nonasking/daijin/docs/README.md

# docs

지금 시스템을 설명하는 문서와, 그때의 판단을 남긴 문서를 나눈다. 코드가 바뀌면 **현행** 문서만 같이 고친다.

## 현행

| 문서 | 무엇 |
|---|---|
| [chunking-protocol.md](chunking-protocol.md) | 오디오 청킹 프로토콜: 헤더 `[clipId][seq:2][flags]`, 양방향 ADPCM, 재조립 규칙 |
| [design-self-layer.md](design-self-layer.md) | 자아 층 설계: 장부·추동·기억·반성, 로컬 음성 스택, "일부러 꺼 둠" |
| [broker-credentials.md](broker-credentials.md) | 브로커 자격증명을 브레인·디바이스·노드로 나누는 이유와 방법 |
| [research-self-local.md](research-self-local.md) | 자아의 방향과 외부 API 없는 구성 리서치 (비공개) |

## 기록 (그때의 계획, 지금과 다를 수 있다)

| 문서 | 무엇 | 지금과 다른 점 |
|---|---|---|
| [demo-video-plan.md](demo-video-plan.md) | 2026-09 데모 영상 기획. 영상은 찍었다 (README의 Demo) | dev2 는 서보가 아니라 스텝모터 간식 디스펜서가 됐다 (`voice/nodes.json`) |
| [learning-roadmap.md](learning-roadmap.md) | 2026-06 키트 배송 전 학습 로드맵 | 학습 단계는 끝났다 |
| [daily-plan.md](daily-plan.md) | 2026-06 교재 기준 일별 계획 | 같음 |
| [day1-checklist.md](day1-checklist.md) | 2026-06 도착 첫날 체크리스트 | 같음 |
| [study-resources.md](study-resources.md) | 2026-06 입문·트러블슈팅 자료 큐레이션 | 자료 자체는 아직 쓸 만하다 |
| [research-cloud-robotics.md](research-cloud-robotics.md) | 2026-06 Cloud Robotics 리서치 (deep-research) | 클라우드 브로커 선택의 근거로 남는다 |

개선 과제의 우선순위 표는 [`research/2026-10-improvements/report.md`](../research/2026-10-improvements/report.md) (비공개).
