nonasking/daijin/docs/research-cloud-robotics.md

# 리서치: 내 IoT 원격제어 프로젝트 ↔ Cloud Robotics & Teleoperation

> deep-research 결과 (2026-06-14). 23개 소스 → 111개 주장 추출 → 25개 적대적 검증 → **21개 확정, 4개 기각**.
> 목적: 내 프로젝트가 Physical AI(cloud robotics·teleoperation)와 닿는지 검증 + 아이디어 발굴.

## 🧭 이 보고서를 어떻게 쓸 것인가 (작업 철학 — 먼저 읽기)
이 보고서는 **검증기·가속기**로 쓰는 것이지 **아이디어 생성기**로 쓰는 게 아니다. 두 층으로 분리해서 사용:
- **구현층 (어떻게 만드나)** → 여기 담긴 prior art(MQTT/WebRTC 이중 프로토콜, micro-ROS 등)를 **탐욕적으로 흡수.** 삽질(불필요한 트러블슈팅)을 줄이는 순이익.
- **비전·발상층 (무엇을·왜 만드나)** → 이 보고서를 **느슨하게** 쥔다. "원래 이렇겐 안 한다"가 아이디어를 죽이게 두지 않는다.
- 한 줄: **"구현은 탐욕적으로, 비전은 순진하게."**
- 순서: **발산(자유 발상) 먼저 → 그 다음 이 보고서로 매핑/검증.** 프레임워크와 **갈라지는 지점은 오류가 아니라 차별화 후보(기회 신호).**
- 🔖 **"원래는 안 하는 건데" 노트**: 분야 자료에서 "보통 이렇겐 안 하더라" 싶은 게 나오면 지우지 말고 적어둔다 → 대부분의 차별화가 여기서 나온다.

> 프레임워크 = 존재하는 것의 *지도*(descriptive)이지 가능한 것의 *규칙*(prescriptive)이 아니다. 가두는 건 프레임워크가 아니라 그걸 규칙으로 착각하는 나 자신.

---

## 한 줄 결론
가설은 **강하게 지지됨** — 단 정확한 위치는 "cloud robotics 그 자체"가 아니라 **"teleoperation의 입문 골격 + cloud robotics에 인접한 인프라"**. 이 교차점은 실제로 활발한 연구·창업 영역.

⭐ **그리고 이 "갈라지는 지점"이 핵심**: 아래 §1에서 내 프로젝트가 정의에서 벗어나는 부분(자가호스팅·0원·프라이버시 우선)은 **약점이 아니라 나만의 각도 = 차별화 무기**다. 분야를 알았기에 이 윤곽이 선명해진 것 — 프레임워크가 아이디어를 가둔 게 아니라 *드러낸* 사례.

---

## 1. 가설 검증 (정직하게)

### ✅ 진짜 닿아 있음 — 비유가 아니라 같은 부품
2025년 학술 논문(arXiv:2510.11421)이 **정확히 내 스택**으로 6-DOF 로봇팔을 원격조작:
> *"affordable microcontrollers (ESP8266...), and protocols like MQTT and WebRTC... low-cost, scalable robotic teleoperation"* — 제어=MQTT, 영상=WebRTC, 액추에이터=ESP 보드.

ESP32-S3는 ESP8266의 상위 호환 → 취미 프로젝트와 학술 teleoperation이 **동일 프리미티브 연속선상**. (검증 3-0)

### ⚠️ 정직하게 갈라지는 지점
- **Cloud robotics 정의적 핵심 = 연산 오프로딩 + (부분)자율성 + 로봇** (Kuffner 2010 "shared brain"). 내 프로젝트엔 아직 로봇·자율성·오프로딩 없음 → "cloud robotics 그 자체" 아님, **인접 인프라**. (3-0)
- 지금은 **telepresence**(원격에 있다는 감각)이지 **co-presence**(곁에 있다는 지각)는 아직. (3-0)

### 📍 정확한 좌표
teleoperation 스펙트럼의 *"원격 명령"* 끝, 자율성 0. **액추에이터(서보/모터 — 키트에 있음) + 자율성 + 피드백 루프**를 더하면 본격 진입.

---

## 2. 아이디어 발굴 (단계별)

### 🟢 당장 (지금 키트로)
- **이중 프로토콜 분리** ⭐: 제어=MQTT(저지연), 영상=WebRTC — 한 채널에 다 넣지 말 것. 학술 프레임워크가 의도적 설계로 사용("avoiding bottlenecks typical of monolithic architectures"). ESP32-S3 내장 카메라 영상은 WebRTC로, 제어는 MQTT로. (3-0)
- **센서→broker→원격접근 텔레메트리**: 부모님댁 PIR/온습도 = 학술 "sensor-to-cloud health telemetry"와 동일 패턴. (3-0)

### 🟡 중간 (개념 승격 — "취미→로보틱스" 다리)
- **micro-ROS로 ESP32를 표준 ROS2 노드로 편입** ⭐: 지금 `curl` LED 제어를 ROS2 `/cmd_vel` 토픽으로 승격 → 정식 로보틱스 스택 참여. 체인: `gamepad→teleop→/cmd_vel→micro-ROS Agent→UDP/WiFi→ESP32→PWM`. (참고: Reinbert/ros_esp32cam_diffdrive) (3-0)
- **teleoperation 향상 3축**: ① 운영자 지각(시점/자동화) ② 인터페이스(VR/AR) ③ 제어(latency 보상, 로컬 자율성). (3-0)
- **액추에이터 추가**(서보·모터·릴레이): "표시(LED)"→"물리 작동" = cloud robotics 정의에 근접.

### 🔴 야심 (방향성)
- 모바일 로봇 + 가족이 폰으로 원격조작 + 영상통화 (TurtleBot/ROS 사례) (3-0)
- 자율주행(topological map) telepresence 로봇 — teleoperation 없이 자율 순찰 (3-0)
- **telepresence → co-presence** 진화 (모니터링 → 진정한 원격 현존)
- **자가호스팅 WebRTC 영상 스택**: 방화벽 뒤 ~130ms·E2E 암호화, "Local Mode"(오프라인 자가호스팅) — 내 0원·자가호스팅 철학과 정확히 일치. (3-0)

---

## 3. 핵심 용어
| 용어 | 의미 |
|---|---|
| **Cloud robotics** | cloud + service robotics, 로봇 연산 오프로딩(massively parallel) |
| **Edge computing** | 처리를 엣지로 → latency↓ (edge ~1-10ms vs cloud ~50-200ms) |
| **Teleoperation** | 완전자율 아직 불가 → 인간 원격제어가 실용적 중간지대 |
| **telepresence vs co-presence** | 원격에 있다는 감각 vs 곁에 있다는 지각 |
| **micro-ROS / DDS** | MCU를 ROS2 그래프에 편입(Agent 브리지 경유) |

---

## 4. 진지한 방향 (연구·창업)
- **노인 돌봄 × telepresence = 활성 연구·파일럿·창업 영역** (저비용 AAL, telepresence 로봇 실배치). 기회가 실재. (3-0 / 일부 2-1)
- **내 차별점 = 무기**: 대부분 시스템이 제3자 클라우드 의존인데, 나는 **자가호스팅·0원·프라이버시 우선**. 프라이버시 중시 노인 모니터링은 시장·연구의 **틈새**.

---

## ⚠️ 신뢰도 주의 (검증서 기각/약화)
- **latency 구체 수치 불신**: "MQTT 128.4ms vs WebSocket" 등은 preprint 단일팀·통계검증 없음(2-1, 일부 1-2/0-3 기각). 방향성만 참고, **수치는 직접 측정**.
- "국제망 실시간 teleoperation" 주장은 **반박됨**.

## 📚 핵심 소스
- ⭐ Sun & Tsai, *A Modular AIoT Framework for Low-Latency Real-Time Robotic Teleoperation* — arXiv:2510.11421 (2025) — ESP+MQTT+WebRTC (내 스택과 거의 동일)
- Tahir & Parasuraman, *Edge Computing and its Application in Robotics: A Survey* — arXiv:2507.00523 / MDPI JSAN 2025
- Saha & Dasgupta, *A Comprehensive Survey of Recent Trends in Cloud Robotics* — MDPI Robotics 2018, 7(3):47
- Moniruzzaman et al., *Teleoperation methods and enhancement techniques for mobile robots* (2022)
- Reinbert/ros_esp32cam_diffdrive (GitHub) — micro-ROS ESP32 `/cmd_vel`

---

## 추천 다음 한 걸음
지금 HTTP/curl 제어를 **MQTT로 옮기고 + ESP32-S3 카메라를 WebRTC(또는 우선 MJPEG)로** 붙이면 그 자체로 "teleoperation 이중 프로토콜" 아키텍처 완성. 이후 **micro-ROS 승격**이 로보틱스 본격 진입 다리.
