nonasking/daijin/sketches/15-home-node/broker_choice.h

// 우체국 고르기: 평소엔 클라우드(daijin.inanna.day, TLS), 클라우드에 못 붙으면 집의 우체국(mosquitto, 같은 와이파이)으로.
// 인터넷이 통째로 끊겨도 기기·노드·맥의 브레인이 집 안에서 계속 말을 주고받게 하려는 것.
//
// secrets.h 에 MQTT_LOCAL_HOST 를 넣었을 때만 켜진다 (넣지 않으면 지금까지와 똑같이 클라우드만 쓴다):
//   #define MQTT_LOCAL_HOST "my-mac.local"   // 집 mosquitto 가 도는 기계: 이름(.local, mDNS) 또는 고정 IP
//                                            // 이름을 권한다: 공유기가 IP 를 바꿔도 따라간다 (2026-10-12 실제로 .143 → .189)
//   #define MQTT_LOCAL_PORT 1883
// 계정은 클라우드와 같은 것(MQTT_USER/MQTT_PASS)을 쓴다: 집 우체국도 같은 계정·같은 ACL 이다 (voice/mosquitto/home.acl).
// 예전엔 보드 전부가 공용 계정 하나(MQTT_LOCAL_USER "iot")로 붙었고, 그 비밀번호 하나면 집 우체국에서 무엇이든 할 수 있었다.
// 집 우체국의 계정이 정말 달라야 하면 MQTT_LOCAL_USER / MQTT_LOCAL_PASS 를 따로 적는다.
// 동작: 시각을 못 얻어 인증서를 검증할 수 없거나 클라우드 접속이 3번 연달아 실패하면 집 우체국으로 간다.
//       집 우체국에 있는 동안 5분마다 클라우드를 다시 시도하고, 붙으면 돌아간다. 집 우체국에 붙어 있는 중이면 dueForCloud() 가
//       5분이 됐음을 알려 주고, 호출자가 한가할 때 연결을 끊어 다시 고르게 한다 (2026-11-01 리뷰: choose() 는 끊겨 있을 때만 불려서
//       집 우체국에 한번 붙으면 브로커가 돌아와도 거기 머물렀다).
// 집 우체국은 같은 와이파이 안이라 암호화 없이(평문) 붙는다. 그 망을 믿을 수 있을 때만 쓸 것.
//
// 14-daijin 과 15-home-node 에 같은 파일이 들어 있다 (tls_time.h 처럼 스케치마다 한 벌).
#pragma once
#include <WiFi.h>
#include <WiFiClientSecure.h>
#include <PubSubClient.h>
#include "tls_time.h"
#if defined(MQTT_LOCAL_HOST)
#include <ESPmDNS.h>
#endif

#if defined(MQTT_LOCAL_HOST)
#define HAS_LOCAL_BROKER 1
#ifndef MQTT_LOCAL_PORT
#define MQTT_LOCAL_PORT 1883
#endif
#else
#define HAS_LOCAL_BROKER 0
#endif

struct BrokerChoice {
  WiFiClientSecure* tls = nullptr;
  WiFiClient plain;
  PubSubClient* mqtt = nullptr;
  bool onLocal = false;
  bool tlsReady = false;            // 클라우드용 인증서 검증 준비가 끝났나 (시각을 얻었나)
  uint8_t cloudFails = 0;
  uint32_t localSince = 0;
  bool resolveAgain = false;        // 집 우체국 접속이 실패했으면 다음 시도 전에 이름을 다시 찾는다
  static const uint8_t CLOUD_FAILS_TO_LOCAL = 3;
  static const uint32_t RETRY_CLOUD_MS = 5UL * 60 * 1000;

  void begin(WiFiClientSecure& t, PubSubClient& m, bool clockReady) {
    tls = &t; mqtt = &m; tlsReady = clockReady;
    if (tlsReady) tls->setCACert(ISRG_ROOT_X1);
    useCloud();
  }
  bool enabled() const { return HAS_LOCAL_BROKER; }
  const char* name() const { return onLocal ? "local" : "cloud"; }
  const char* user() const {
#if HAS_LOCAL_BROKER && defined(MQTT_LOCAL_USER)
    if (onLocal) return MQTT_LOCAL_USER;
#endif
    return MQTT_USER;
  }
  const char* pass() const {
#if HAS_LOCAL_BROKER && defined(MQTT_LOCAL_PASS)
    if (onLocal) return MQTT_LOCAL_PASS;
#endif
    return MQTT_PASS;
  }
  void useCloud() {
    onLocal = false;
    mqtt->setClient(*tls);
    mqtt->setServer(MQTT_HOST, MQTT_PORT);
  }
  void useLocal() {
#if HAS_LOCAL_BROKER
    onLocal = true; localSince = millis(); resolveAgain = false;
    mqtt->setClient(plain);
    IPAddress ip;
    if (resolveLocal(ip)) mqtt->setServer(ip, MQTT_LOCAL_PORT);
    else mqtt->setServer(MQTT_LOCAL_HOST, MQTT_LOCAL_PORT);   // IP 로 적었거나 못 찾았으면 그대로 (못 찾으면 접속이 실패하고 다시 찾는다)
#endif
  }
#if HAS_LOCAL_BROKER
  // "이름.local" 이면 mDNS 로 지금의 IP 를 찾는다.
  static bool resolveLocal(IPAddress& out) {
    String host = MQTT_LOCAL_HOST;
    if (!host.endsWith(".local")) return false;
    static bool mdnsUp = false;
    if (!mdnsUp) {
      char me[24]; snprintf(me, sizeof me, "daijin-%06llx", ESP.getEfuseMac() & 0xFFFFFF);
      mdnsUp = MDNS.begin(me);
    }
    if (!mdnsUp) return false;
    out = MDNS.queryHost(host.substring(0, host.length() - 6), 2000);
    Serial.printf("집 우체국 %s → %s\n", MQTT_LOCAL_HOST, out == IPAddress() ? "못 찾음" : out.toString().c_str());
    return out != IPAddress();
  }
#endif
  // 집 우체국에 붙어 있고 클라우드를 다시 볼 때가 됐나. 호출자는 재생·녹음 중이 아닐 때 mqtt->disconnect() 하고 다시 접속한다.
  bool dueForCloud() const { return HAS_LOCAL_BROKER && onLocal && mqtt && mqtt->connected() && millis() - localSince >= RETRY_CLOUD_MS; }
  // 접속 시도 직전에 부른다: 어느 우체국으로 갈지 정한다. 바뀌었으면 true.
  bool choose() {
    if (!HAS_LOCAL_BROKER) return false;
    if (onLocal) {
      if (millis() - localSince < RETRY_CLOUD_MS) {
        if (resolveAgain) { uint32_t since = localSince; useLocal(); localSince = since; }
        return false;
      }
      if (!tlsReady && syncClock(3000)) { tls->setCACert(ISRG_ROOT_X1); tlsReady = true; }
      localSince = millis();                       // 실패해도 다음 재시도는 5분 뒤
      if (!tlsReady) return false;
      cloudFails = CLOUD_FAILS_TO_LOCAL - 1;      // 한 번 더 실패하면 바로 집으로 돌아온다
      useCloud(); return true;
    }
    if (!tlsReady || cloudFails >= CLOUD_FAILS_TO_LOCAL) { useLocal(); return true; }
    return false;
  }
  // 접속 시도 결과를 알려 준다.
  // 시험용: -DBROKER_TEST_CLOUD_DOWN 으로 빌드하면 클라우드 접속이 늘 실패한 것으로 친다 (인터넷을 끊지 않고 폴백을 보려고).
  // 돌려주는 값이 실제로 붙었는지다 (시험 빌드에서는 클라우드 접속을 끊고 false).
  bool result(bool ok) {
#ifdef BROKER_TEST_CLOUD_DOWN
    if (!onLocal) { cloudFails = 255; if (ok) mqtt->disconnect(); return false; }
#endif
    if (onLocal) { resolveAgain = !ok; return ok; }
    cloudFails = ok ? 0 : (cloudFails < 255 ? cloudFails + 1 : 255);
    return ok;
  }
};
