nonasking/daijin/sketches/12-mqtt-led-funnel/ca_cert.h

// Funnel(Let's Encrypt) 서버 검증용 루트 CA — 공개 인증서(비밀 아님)
#pragma once
const char* ISRG_ROOT_X1 = R"EOF(
-----BEGIN CERTIFICATE-----
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
-----END CERTIFICATE-----
)EOF";
