nonasking/daijin/(commit log)

2026-06-20 daijin — ESP32-S3 AI voice friend IoT (public snapshot)
2026-07-04 daijin Phase 2: the device listens and speaks — full streaming voice pipeline
    Device (sketches/14-daijin): INMP441 record (32-bit I2S, tap-toggle) ->
    chunked upload over HiveMQ TLS -> jitter-ring-buffer playback through
    PCM5102 amp module. WiFiMulti (home + phone hotspot), modem sleep off,
    ready chirp + idle LED. Verification tools: test-mic, test-speaker,
    mic-diag (empirical I2S pin sweep).
    Brain (voice/daijin_mqtt.py): sentence-streaming replies (claude
    stream-json -> TTS per sentence -> publish immediately), ElevenLabs
    custom voice with macOS fallback and TTS_ENGINE switch, IMA ADPCM 4:1
    encode (EU-broker RTT x ESP32 TCP window caps ~19KB/s; PCM needs 32,
    ADPCM needs 8), QoS0 streaming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
    [14-daijin.ino, ca_cert.h, mic-diag.ino, test-mic.ino, test-speaker.ino]
2026-07-04 Unlock full agent tools for the brain (user decision)
    allowedTools: led.sh-only -> Bash, WebSearch, WebFetch, Read/Glob/Grep,
    Write/Edit. daijin can now search the web, explore files, and run
    commands by voice. System prompt requires spoken confirmation before
    destructive/irreversible actions. Security boundary is now the broker
    credential — noted in code.
    Claude-Session: https://claude.ai/code/session_01RS5iRpBoUzLCNUEnocsRzn
2026-07-04 Smart WiFi sleep + device self-status (temperature by voice)
    Device: modem sleep ON when idle (heat/battery), OFF only during
    record/playback sessions (full RX throughput when it matters);
    publishes {temp_c, ssid, rssi, uptime, heap} retained to daijin/status
    every 60s.
    Brain: status.sh reads the retained status; system prompt teaches
    daijin to answer "how hot are you?" like body temperature.
    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
2026-07-04 Digital volume control (TTS_VOLUME) — fixes metallic distortion on the small speaker
    Full-scale TTS audio was clipping the tiny amp+speaker into a metallic
    edge (A/B confirmed clean on Mac, harsh on device). Scale samples in
    the ADPCM encoder; level set via TTS_VOLUME in secrets (0.8 chosen by ear).
    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
2026-07-05 Add free unlimited TTS engine: Edge TTS (Seraphina) as default
    Three-way TTS_ENGINE switch: edge (MS neural multilingual voice, free,
    no quota — chosen by ear) / eleven (custom ElevenLabs voice, credit
    budget reserved for special occasions) / yuna (offline final fallback).
    Edge path: mp3 -> afconvert -> PCM 16k mono.
    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
2026-08-17 Home node fleet: common firmware, control/status tools, proactive speech helper
    Synced from the working repo (esp32-iot). One firmware per NODE_NAME with
    WiFiManager provisioning, retained heartbeat telemetry, and MQTT LWT so a dead
    node is marked offline by the broker within ~30s. dev.sh commands a node and
    verifies its retained ack; fleet.sh judges ONLINE/STALE/OFFLINE per node;
    say.sh triggers daijin's proactive speech. Verified on two ESP32-S3 boards.
    Claude-Session: https://claude.ai/code/session_01B1iRFxP13oMLHn2Jn3HsBs
    [15-home-node.ino, ca_cert.h]
2026-08-17 Voice pipeline overhaul: capture task, upstream ADPCM, proactive say/ask, STT vocab prompt
    Root cause of long-standing choppy recordings: upstream hits the same physics
    as downstream — ESP32 TCP send buffer x EU-broker RTT caps upload at ~19KB/s,
    below raw PCM's 32KB/s, and the single-loop recorder silently dropped samples
    whenever a TLS publish blocked (I2S DMA holds only ~90ms). Fix mirrors the
    downstream design: a dedicated capture task drains I2S into a ring (24KB — a
    48KB ring starved the ~45KB heap TLS needs to re-handshake), and upstream is
    IMA ADPCM-compressed 4:1 so upload keeps up in real time. The brain gains the
    matching decoder, proactive speech topics (daijin/say, daijin/as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
    [14-daijin.ino]
2026-09-12 Home node firmware: multi-WiFi, servo/relay/buzzer/stepper verbs, per-node feature flags
    - WiFiMulti over known networks (home + two phone hotspots) before WiFiManager
    portal fallback, so a node can be moved between locations without reprovisioning
    - New verbs: poke (one-shot servo), relay:pulse, buzz presets, step (28BYJ-48),
    motor (node-agnostic: poke on servo nodes, step on stepper nodes), caps
    - servo:<angle> reports :nochange when already there (invisible move)
    - FEAT_* guarded by #ifndef so flash-node.sh can enable only what is wired
    (dev1 = servo/buzzer/relay, dev2 = stepper/buzzer); NODE_NAME via build flag
    - Heartbeat carries ssid so fleet shows which network each node is on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
    [15-home-node.ino]
2026-09-12 daijin device: SSD1306 face tied to pipeline state, shorter playback prebuffer
    - 128x64 I2C OLED (SDA 8, SCL 9) draws idle/listen/upload/think/speak/error faces;
    skipped cleanly when no display is attached
    - Playback prebuffer 0.75s -> 0.4s (ADPCM 8KB/s vs ~19KB/s link headroom)
    Claude-Session: https://claude.ai/code/session_01LRbKBRxFqPgTjqpy8THuyt
    [14-daijin.ino]
2026-09-12 Brain: stage props file, faster model options, node aliases in STT
    - props.txt is appended to the system prompt: what is physically attached to each
    node and the prank rules (check fleet first, ack != physical result, retry on err)
    - claude -p runs with BRAIN_MODEL (default sonnet-5) and MCP disabled; cuts
    startup and first-token latency
    - STT output normalizes dev1/데브 1/대부 1 to 1번 before the agent sees it;
    STT vocabulary prompt uses 1번/2번 wording
    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
2026-09-12 Control tools: local broker bridge, fixed ack race, node aliases, status mirror
    - Scripts talk to local mosquitto (1883) when it is up and fall back to HiveMQ;
    the broker bridges cmd out and state/status/event in (config lives outside repo)
    - dev.sh subscribes before publishing (-R) so a retained previous ack can no longer
    be reported as the current one; err:unknown prints the node's caps inline;
    offline nodes are rejected immediately from retained status; accepts 1/1번/dev1
    - fleet_watch mirrors cloud status to the local broker as retained (bridged live
    messages lose the retain flag), and fleet output keeps the newest line per node
    - fleet shows the network each node is on
    Co-Auth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
2026-09-15 Fix double-recognition after 10s auto-cut; drop silent and hallucinated clips
    - Device: when recording hits the cap without a button tap, play a distinct
    low double chirp and refuse a new recording until the button has been released
    for 1.5s. Previously the user's late 'stop' tap started a second 10s recording
    that captured the speaker reply and produced a phantom command. Cap 10s -> 12s.
    - Brain: gate clips on speech energy (top-window RMS < 260 is dropped; measured
    phantom clip 180, real speech in the thousands) and drop transcripts that are
    a repeated sentence or a verbatim STT vocabulary example (whisper hallucination).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
    [14-daijin.ino]
2026-09-15 Pin a node or the device to one network for cross-network filming
    - WIFI_ONLY=1|2|3 build flag registers only that SSID; without it WiFiMulti still
    picks the strongest known network. Needed because at home every board otherwise
    joins the same router and the three-network demo silently collapses to one.
    - flash-node.sh takes an optional home|hot1|hot2 third argument.
    - Ignore voice/archive (rotated logs and retired session ids).
    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
2026-09-16 Spoken node names: 일 번/이 번 in, 1번/2번 out; strip 'ack' and dev1/dev2 from speech
    - STT normalizer also maps 한 번/두 번/일 번/이 번 (and unspaced forms) to 1번/2번,
    leaving count phrases like '한 번 더' and '이번엔' alone
    - speak_fix() rewrites sentences right before TTS: 'ack 받았어' -> '보냈어' /
    '전달됐어', 'ack를 안 줘' -> '응답이 없어', dev1/dev2/1번(dev1) -> 1번/2번 with
    particle repair. The pinned session had said 'ack 받았어' so often that prompt
    rules alone did not change it; TTS read it as '액바닷서'.
    - props: node 1 = needle + water balloon at the park, node 2 = cat treat dispenser
    - fleet shows 1번/2번 without the d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
2026-09-18 Speak text blocks immediately, keep decimals intact, resilient status mirror, per-node servo rest and motor angle
    - Sentence splitter: a period ends a sentence only when whitespace follows, so
    '36.1도' is no longer spoken as '36.' then '1도'; test updated from the old
    'known limitation' to the fixed behaviour
    - Flush the sentence buffer when a text block ends (before a tool call) so the
    lead-in line is spoken before the action instead of merged with the result
    - Speech-energy gate lowered to drop only true silence; real speech measured
    far below the previous threshold on this mic
    - fleet_watch mirrors to the local broker with connect_async + auto-reconnect;
    it previously gave up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
    [15-home-node.ino]
2026-09-21 Derive all paths from the repo location instead of ~/esp32-iot
    Every script hard-coded $HOME/esp32-iot, so a clone under any other name
    (the repo is called daijin) could not find secrets.local.txt or its
    siblings. Python modules now resolve VOICE/REPO/SEC from __file__, shell
    helpers from BASH_SOURCE, and whisper-cli/claude fall back to PATH lookup.
    LaunchAgent plists carry __REPO__/__HOME__ placeholders that
    voice/install-agents.sh fills in and registers.
    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
2026-09-22 Point the agent at dev.sh for LEDs; retire led.sh
    led.sh published to home/led/set, which only the 11–13 learning sketches
    subscribe to. The current device and nodes never saw it, so the agent
    reported 'OK' for LED requests that did nothing. The system prompt now
    uses 'dev.sh all led:<color>'. led.sh is kept as legacy-led.sh with a note.
    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
2026-09-22 Call the nodes red and blue
    Spoken node names were 일 번 / 이 번 ("one" / "two"), which differ by a
    single final consonant. Measured on 144 synthetic utterances with pink
    noise, whisper confused them 4/16 times even from raw PCM; red / blue were
    confused 0/16. Internal ids stay 1번/2번 (dev1/dev2).
    - normalize_nodes maps 레드/red → 1번 and 블루/blue → 2번; the older
    spoken forms and dev1/dev2 are still accepted. Korean colour words are
    left alone because they are LED colour commands.
    - STT vocabulary prompt rewritten around the new names plus the phrases
    that measurably helped; the hallucination sentence list is now derived
    from that prompt instead of a stale copy.
    -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
2026-09-22 Node firmware: idle LED shows the node's own colour
    NODE_COLOR build flag (flash-node.sh passes red for dev1, blue for dev2)
    sets the online colour so the name and the light agree. The
    connecting-to-broker indicator moves from red to yellow so a red node is
    not ambiguous while it reconnects.
    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
    [15-home-node.ino]
2026-09-29 Optional local extension point: voice/local_hooks.py and props.local.txt
    An install can now carry its own behaviour without editing tracked files.
    If voice/local_hooks.py exists (gitignored), the brain and the fleet watcher
    load it:
    - STT_PROMPT_EXTRA: extra vocabulary sentences for the STT prompt
    - intercept(text, kind, ctx): answer or act without the agent round trip
    (shortcuts, fast commands); a crashing hook falls through to the agent
    - mute_reports(): pause the fleet watcher's proactive reports
    voice/props.local.txt, when present, is read instead of props.txt, which
    stays in the repo as the example.
    Claude-Session: https://clau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
2026-10-04 Firmware: keep verifying TLS without NTP, queue node commands, reliable stop tap
    Both sketches
    - tls_time.h: when NTP is blocked the clock is set from the Date header of
    a plain HTTP response, so certificate verification stays on. Connecting
    unverified is now opt-in (-DALLOW_INSECURE_TLS=1). The boot log says
    where the time came from; -DTLS_TIME_SKIP_NTP exercises the fallback.
    Device (14-daijin)
    - The capture task, not the upload loop, decides when recording stops, and
    an interrupt latches short presses. A stop tap during a blocked publish
    used to be missed and the clip ran to the 12 s auto-cut.
    - One MQTT attempt per loop pass next to the WiFi check, so moving between
    networks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
2026-10-04 Docs: protocol as it runs today, splitting broker credentials
    docs/chunking-protocol.md described raw PCM, QoS 1 and 4096-byte chunks.
    It now covers IMA ADPCM both ways, QoS 0, 2048-byte chunks, how each side
    recognises a new clip, and the no-reply signal.
    docs/broker-credentials.md: separate broker logins for brain, device and
    nodes with topic permissions.
    README: layout, Linux steps and the TLS lesson brought up to date.
    Claude-Session: https://claude.ai/code/session_01HcqYfTwDPAqfZMJQNnwnjw
2026-10-11 Device firmware: end recording when the speaker goes quiet; 0.2 s prebuffer
    An energy VAD in the capture task tracks the noise floor and ends the
    clip once speech has lasted 300 ms and then 700 ms of quiet follow. The
    second tap still works and the 12 s cap stays. Playback starts after
    0.2 s of buffered audio instead of 0.4 s.
    Claude-Session: https://claude.ai/code/session_013h5WzrLmW9P9rTSyQ2ingF
2026-10-11 A self outside the model: drives, the rebuff ledger, nightly reflection
    daijin's self now lives next to the brain instead of inside the model's
    session, so the model can change without daijin becoming someone else.
    - selfdb.py: SQLite store for episodes, proactive asks and their outcome
    (the rebuff ledger), drives, per-drive policy, memories with validity
    spans, and persona versions.
    - initiative.py: turns body readings into three drives (contact, node
    loss, body), passes them through an admissibility filter (quiet hours,
    daily budget, per-drive back-off, avoided hours, not mid-conversation)
    and speaks first. It watches the bus, so every proactive line from any
    source is ledgere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
2026-10-11 Docs: the self-layer design; README
    docs/design-self-layer.md: the schema, the v1 drives, the admissibility
    filter, reply classes and what each does to the policy, repair, the
    nightly reflection, and the local voice engines. README gains a section
    on where daijin's self lives, plus the new files and services.
    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
2026-10-12 A local thinking engine, and rules that need no model
    BRAIN_ENGINE picks how daijin thinks: claude (default), local (any
    OpenAI-compatible endpoint such as Ollama or llama.cpp), or an order
    like "claude,local" that falls back when the first gives no answer.
    The local engine gets three tools only: node command, fleet status,
    device status. Invented commands are refused against the firmware's
    verbs, a reply claiming an action no command carried out is replaced,
    and stray Han characters are removed. Its memory is the last two days
    of episodes from the self layer, plus that day's turns when asked about
    "어제" or "그저께", and it is told the date and which model it is.
    fastpath.py answers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
2026-10-12 Firmware: fall back to a home broker when the cloud is out of reach
    broker_choice.h (one copy per sketch): with MQTT_LOCAL_HOST in
    secrets.h, the device and nodes move to a mosquitto on the home WiFi
    after three failed cloud connects, or at once when there is no clock to
    check certificates, and try the cloud again every five minutes.
    Without it nothing changes. A ".local" name is looked up with mDNS, so
    a changing DHCP address does not break it.
    The home broker is plain MQTT on the local network. Status and
    heartbeats carry "broker". Checked on the device and both nodes with
    -DBROKER_TEST_CLOUD_DOWN, which treats every cloud connect as failed
    (flash-node.sh takes EXTRA_FLAGS for this).
    Co-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
2026-10-13 Docs: esp32-iot lives under ~/dev now
    Claude-Session: https://claude.ai/code/session_014L8UynKpcukWtzdY1rWijt
2026-10-18 Initiative: repair lines in plain Korean, nothing said to a switched-off device
    Repair lines use the stored reason of the refused ask, join it without
    a doubled "라서", and open with 아까는 / 어제는 / 지난번엔 by when that
    ask was. The admissibility filter ends with a device check: if
    daijin/status is offline or silent for three minutes, the line is held
    and no ask is opened, so an unheard line cannot double the interval. A
    held drive is logged once, not every minute.
    Claude-Session: https://claude.ai/code/session_017pV7MXQgu35FqVuRyqY4ue
2026-10-18 Fleet watcher: wait 90 s before saying a node went off
    A node that comes back within 90 s (reboot, reflash, a cable swap) is
    not news; one still off after that is reported once, and its return
    after a reported outage is still announced.
    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
2026-10-18 Device: end-of-speech tuned on real conversations; 20 s turns; vad_lab
    Ten recorded turns replayed through the firmware's own rule showed it
    cutting 7 of 10 mid-sentence: thinking pauses run past 0.7 s, the
    400/240 floors counted soft word endings as quiet, and the noise floor
    rose on speech. Now 1.5 s of unbroken quiet ends a turn, the floors are
    150/80, the floor rises only on quiet blocks, and turns may run 20 s.
    voice/vad_lab.py records clips and replays rule variants; a test keeps
    its default equal to the firmware's constants.
    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
2026-10-23 Node loss: a node the person switched off on purpose is not asked about
    When the person says a node is off on purpose ("레드는 일부러 꺼 놨어",
    "일부러 꺼졌으니까 신경 쓰지 마"), node_state.excused_at marks it and
    node_loss leaves it out until it comes back on. With no node named, the
    excuse covers every node that is off, unless the person is talking about
    the daijin device itself. The brain's state block says "일부러 꺼 둠" too.
    Node names are found as words (레드랑 yes, bored no) by one helper,
    nodes.mentioned(), shared with the fast path; the local model's "지금"
    comes from fastpath.now_line() and the same weekday table.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
2026-10-23 Brain: the ADPCM codec in its own module, and a lost uplink chunk is logged
    audio_codec.py holds the IMA ADPCM encoder/decoder and the WAV helpers;
    the brain re-exports them so dm.AdpcmEnc keeps working, and vad_lab no
    longer imports the whole brain to decode a clip (T_AUDIO_IN now lives
    in daijin_common). The uplink is QoS 0, so a middle chunk can go
    missing and ADPCM distorts everything after it; reassembly now logs
    which seqs were lost and still passes the clip on. The Claude pipe is
    closed and the process killed if the reader stops early, and secrets,
    session and props files are closed after reading.
    Claude-Session: https://claude.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
2026-10-23 Close what is opened, drop unused imports, test the shared firmware headers
    selfdb_merge and persona close their connections and files, and the
    tests run without ResourceWarnings. A new test keeps broker_choice.h,
    tls_time.h and ca_cert.h equal in 14-daijin and 15-home-node, since
    Arduino builds each sketch from its own copy.
    Claude-Session: https://claude.ai/code/session_01AdPBwjKkcm6ar2wGsvot9c
2026-10-25 Device: RoboEyes face with pupils; the eyes blink, glance around and show each stage
    The hand-drawn face gives way to FluxGarage RoboEyes: two eyes that
    blink on their own, look around when idle, grow when listening, look up
    while uploading, glance upper-left and upper-right while thinking, smile
    while speaking, tilt at "nothing to say", and sweat on an error. The
    eyes draw on a canvas whose display() does nothing, the sketch adds a
    pupil to each open eye shifted toward the gaze, and flushes once, so
    I2C cost is one frame. 12 fps idle, 6 fps while speaking or uploading;
    an 8-second sentence played with zero underruns.
    Claude-Session: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
2026-10-26 Own broker: Mosquitto on the VPS with per-device ACL; install script and the move written up
    Claude-Session: https://claude.ai/code/session_01GkMrHougMfi1ymVxHFkaPS
2026-10-28 OTA: boards update over HTTPS with a SHA-256 check; ota.sh does the whole round
    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
2026-10-28 README: the broker moved onto the brain's server; boards update over the air
    The architecture diagram and text described HiveMQ Cloud as the broker.
    They now describe Mosquitto on the VPS with a login per device and the
    ACL that keeps a node's login off the agent's topics, with HiveMQ as
    the hosted alternative it was first built against. Status, layout,
    stack and run-it-yourself gain the OTA path (install-server.sh once,
    then sketches/ota.sh), the measured downstream rate before and after
    the move, and two lessons from doing it: fail OTA by keeping the old
    image until the hash matches, and print a generated password at once.
    Claude-Ses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
2026-11-01 Security review, first batch: narrow node ACL, unknown node ids dropped, renewal via webroot, safer backup, resident brain cleanup
    The nodes login now writes only its own status/state/event and reads
    its cmd; node ids not in nodes.json never reach text the agent reads.
    The OTA server script really switches certbot renewal to webroot and
    fails loudly if the dry-run does. Backups go through a .part file and
    the key is never created unattended. A turn that is not read to its end
    drops the resident claude process, the engine generator is closed
    explicitly (Python 3.12 left the lock held), the heartbeat no longer
    waits on a turn, and a missing CLI hands over to the local engine.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
2026-11-02 Firmware: OTA only from our own server on the cloud broker, with rollback; back to the cloud from the home broker
    ota.h accepts only https://<MQTT_HOST>/fw/ and only on the cloud broker.
    A new image boots unconfirmed and confirms on its first cloud
    connection; otherwise it rolls back after five minutes (tested on the
    device with a build that never reaches the cloud: it rolled back at
    exactly five minutes and came back on the previous image). Boards on
    the home broker retry the cloud every five minutes even while
    connected. The device drops playback that starts while the mic is open
    and cancels a take if the capture task cannot be created. ota.sh takes
    EXTRA_FLAGS for test builds. home.acl ca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
2026-11-09 Home broker: a board logs in as itself; same logins and ACL as the main broker, no bridge
    On the home broker every board used one shared login with no ACL, and a
    bridge carried the brain's login to the main broker. broker_choice.h
    now uses the board's own login there too, the home broker takes the
    same three users with home.acl, and the docs say not to bridge it.
    Claude-Session: https://claude.ai/code/session_01BTGLPJ4CBYWGppDfhVFc9S
2026-11-09 Review follow-ups: brain and self-layer hardening, reflect without tools, three dead scripts removed
    Clip reassembly is locked and starts only at seq 0; the session file is
    written atomically; whisper-cli has a timeout; the proactive prefix goes
    to Claude only. An ask closes once and a repair strategy lands on the
    ask its line opens. Reflect runs with --tools "", records a timeout as
    an error and tries the broker once. flash-node.sh stops on unknown
    nodes and offline sync refuses while the offline brain runs. One
    builder for the claude command line and one sentence splitter.
    daijin_server.py, talk.sh and legacy-led.sh are gone: nothing called
    them and they called a script that no longer exis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
2026-11-09 Home broker ACL: the interim shared login keeps only the device's topics
    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
2026-11-09 The shared home-broker login is gone; one login per role on both brokers; the fleet watcher's local mirror removed
    home.acl is the main broker's ACL and nothing else (a test compares the
    user lists). The brain's offline path and nodectl use the same login on
    either broker. All three boards were updated over the air and confirmed;
    a node given a build that cannot reach the main broker joined the home
    broker as itself and rolled back five minutes later.
    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
